yash-k99/vsdsram/Simulation/Prelayout/cell6T_read.cir

6T SRAM Cell

.include osu018.lib

*Access Transistors
M1 bl wl q gnd nfet L=0.2u W=0.4u
M2 blb wl qb gnd nfet L=0.2u W=0.4u
*Inverter 1
M3 q qb vdd vdd pfet L=0.2u W=0.4u
M4 q qb gnd gnd nfet L=0.2u W=0.8u
*Inverter 2 
M5 qb q vdd vdd pfet L=0.2u W=0.4u
M6 qb q gnd gnd nfet L=0.2u W=0.8u

V1 vdd gnd dc 1.8v
Vwl wl gnd pulse 0 1.8 0 60ps 60ps 20ns 40ns
Vq q gnd pulse 0 1.8 0 60ps 60ps 5ns 10ns

.tran 0.1n 100n 
.control
run
plot V(wl)+8 V(bl)+2 V(blb) V(q)+6 V(qb)+4
.endc
.end
